hg-codes/Audio-Amplifier/plots/circuit/BandPassFilter.png

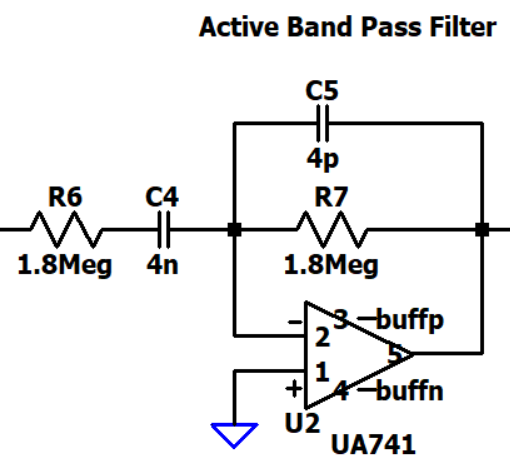
plots/circuit/BandPassFilter.png
