hg-codes/Audio-Amplifier/plots/circuit/FullCkt.png

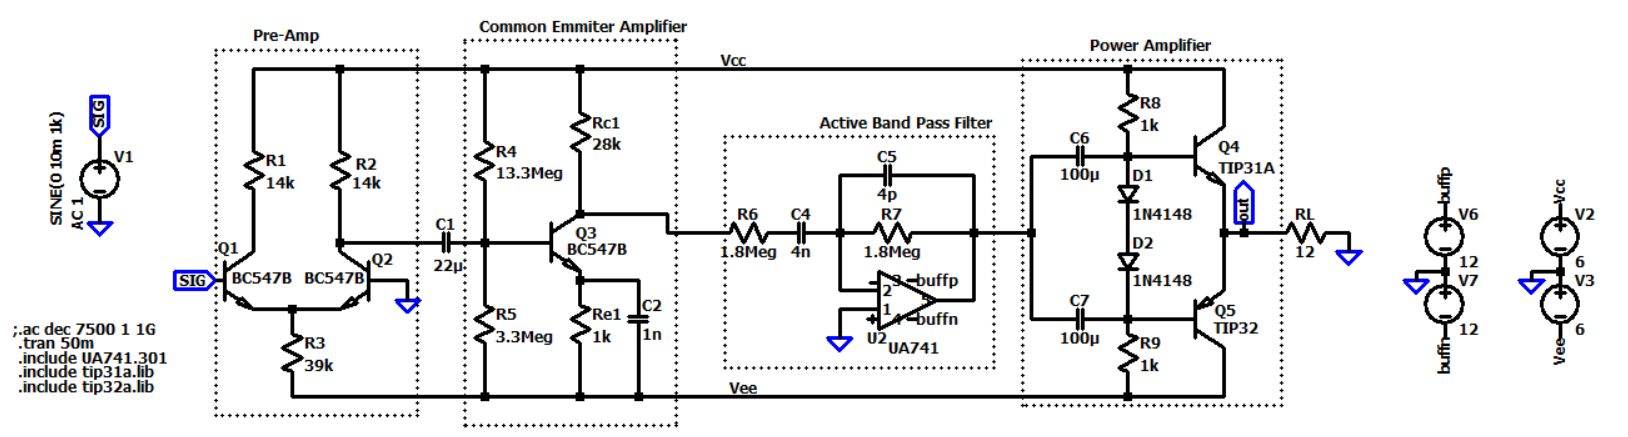
plots/circuit/FullCkt.png
