hg-codes/Audio-Amplifier/plots/circuit/InputSignal.png

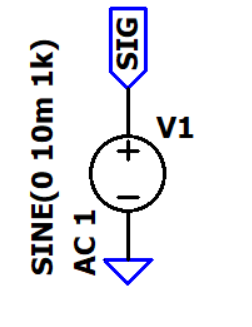
plots/circuit/InputSignal.png
