hg-codes/Audio-Amplifier/plots/circuit/InputSupply.png

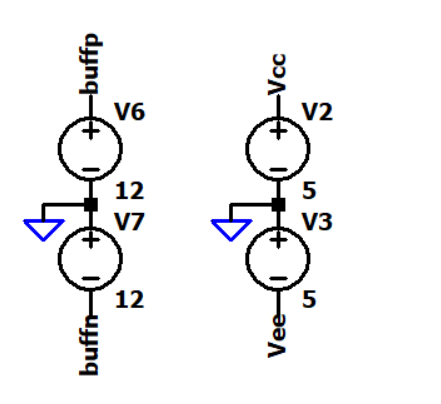
plots/circuit/InputSupply.png
