hg-codes/Audio-Amplifier/plots/spiceplots/BandPassBode.png

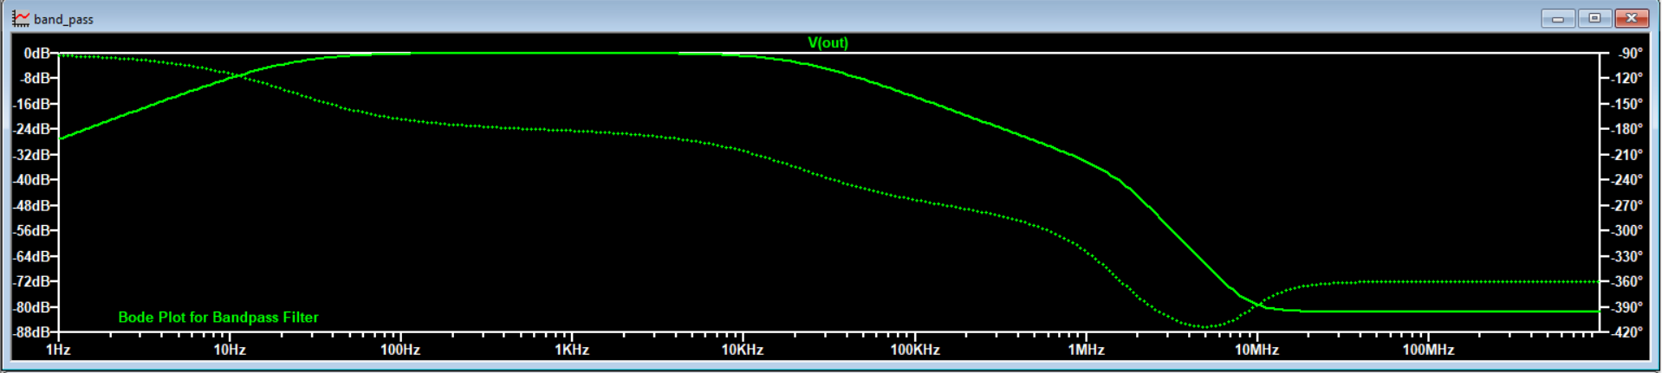
plots/spiceplots/BandPassBode.png
