hg-codes/Audio-Amplifier/plots/spiceplots/Compare.png

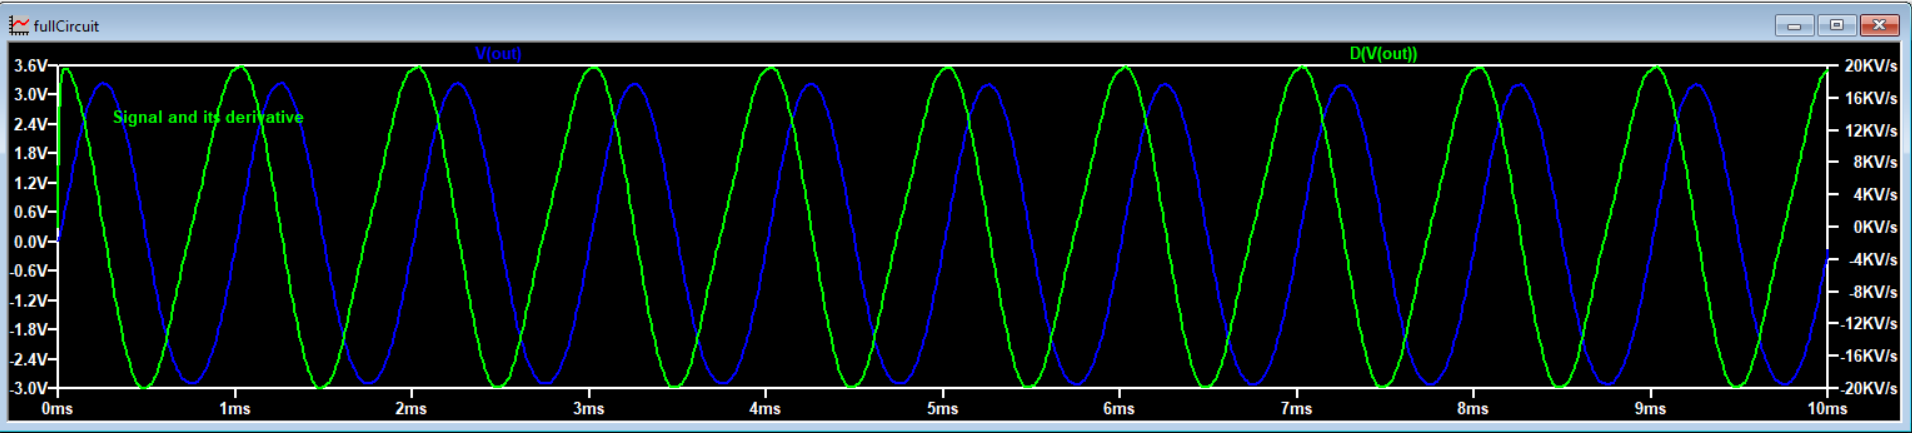
plots/spiceplots/Compare.png
