hg-codes/Audio-Amplifier/plots/spiceplots/FFT4.png

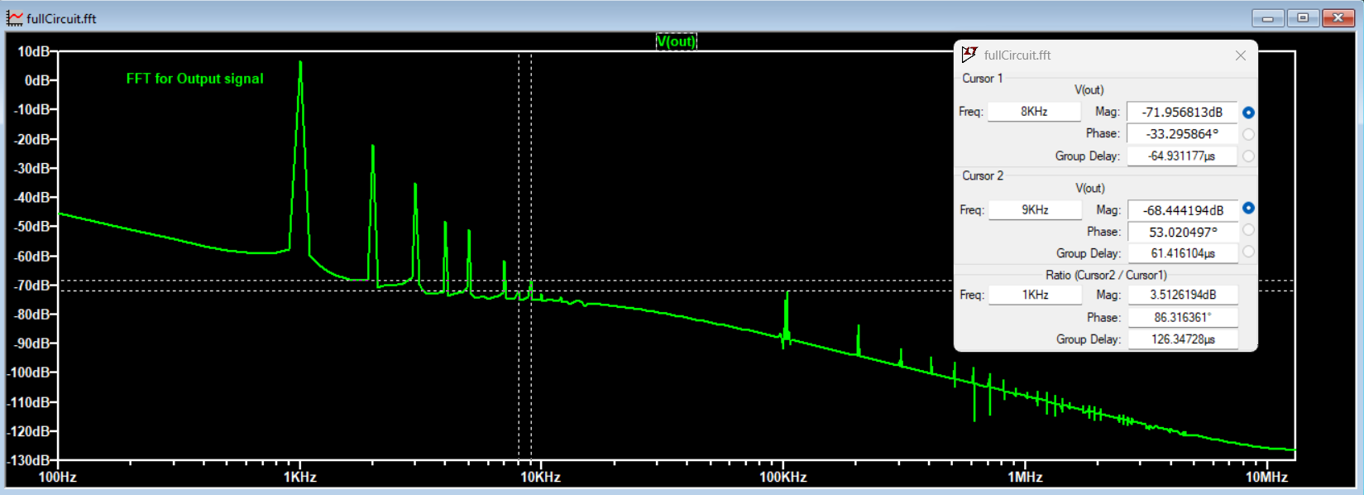
plots/spiceplots/FFT4.png
