hg-codes/Audio-Amplifier/plots/spiceplots/InputPower.png

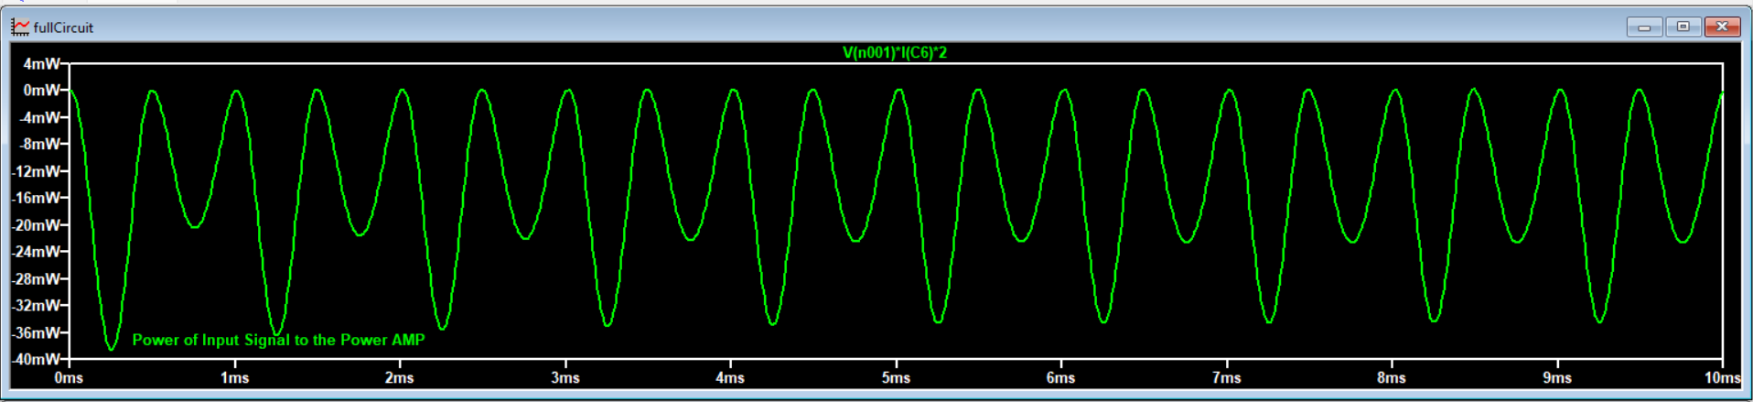
plots/spiceplots/InputPower.png
