hg-codes/Audio-Amplifier/plots/spiceplots/InputSignal.png

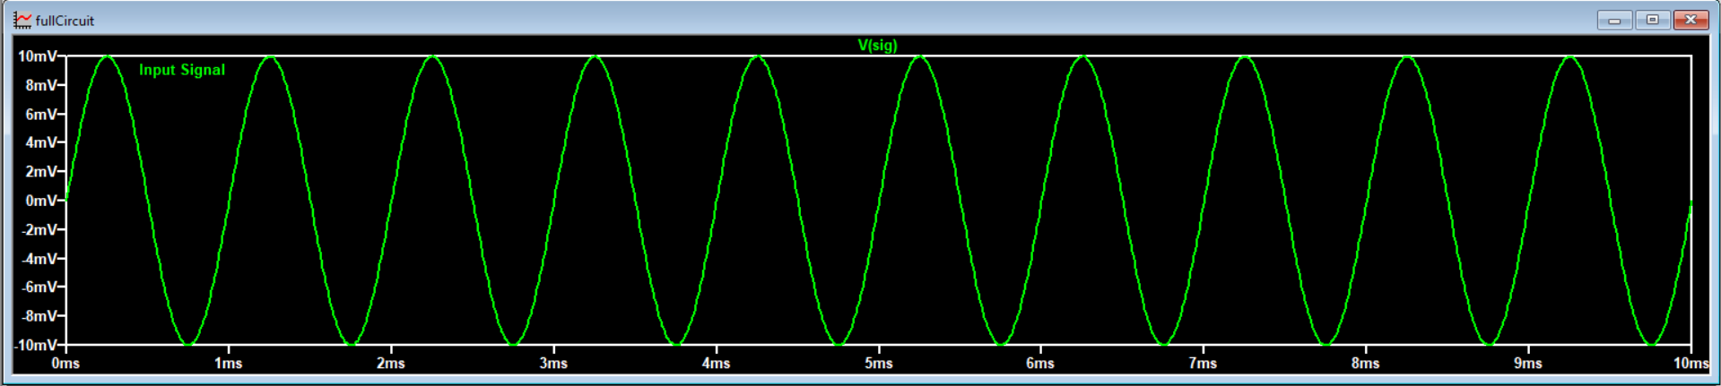
plots/spiceplots/InputSignal.png
