hg-codes/Audio-Amplifier/plots/spiceplots/OutputBode.png

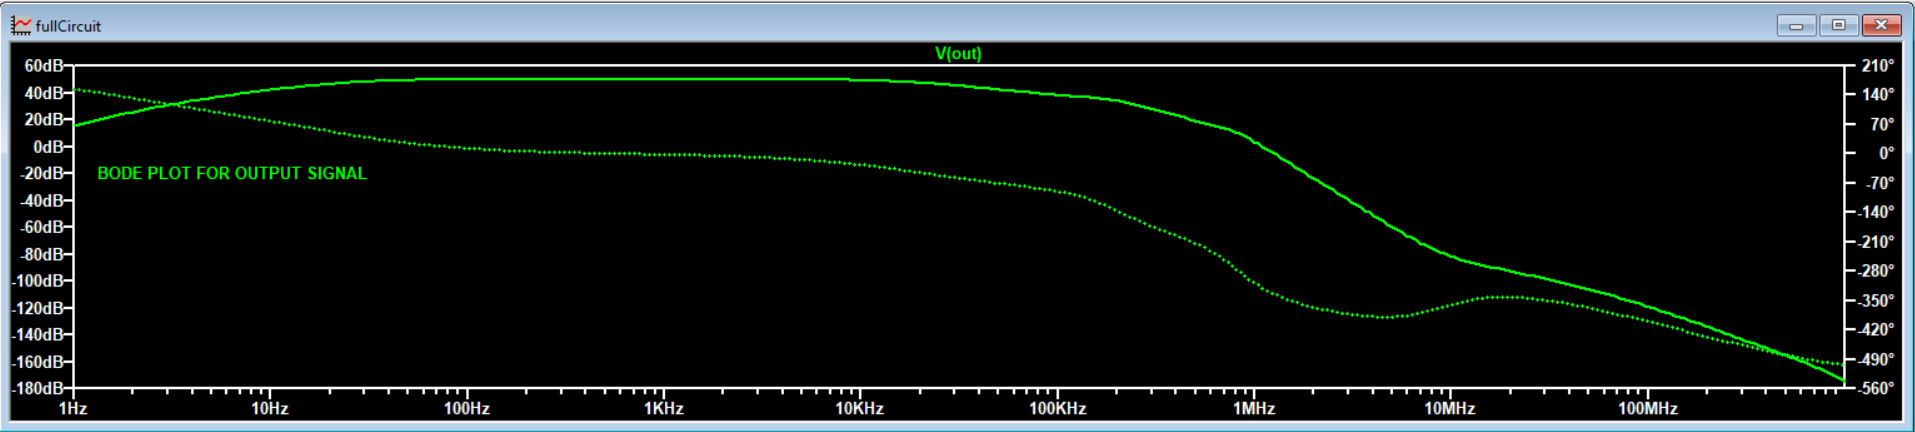
plots/spiceplots/OutputBode.png
