hg-codes/Audio-Amplifier/plots/spiceplots/OutputBodeReadings.png

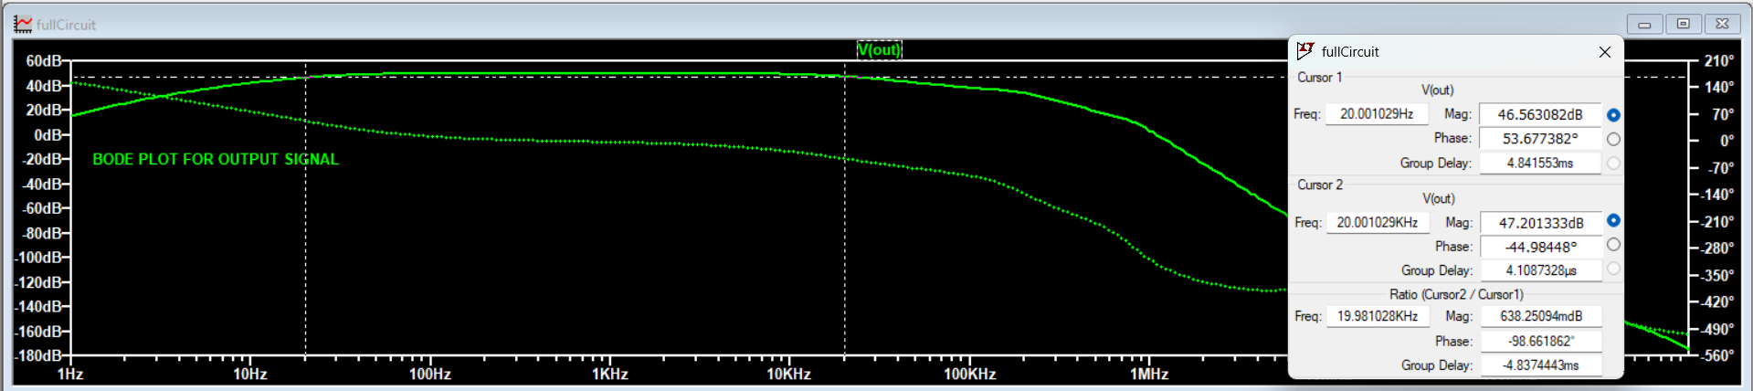
plots/spiceplots/OutputBodeReadings.png
