hg-codes/Audio-Amplifier/plots/spiceplots/OutputPower.png

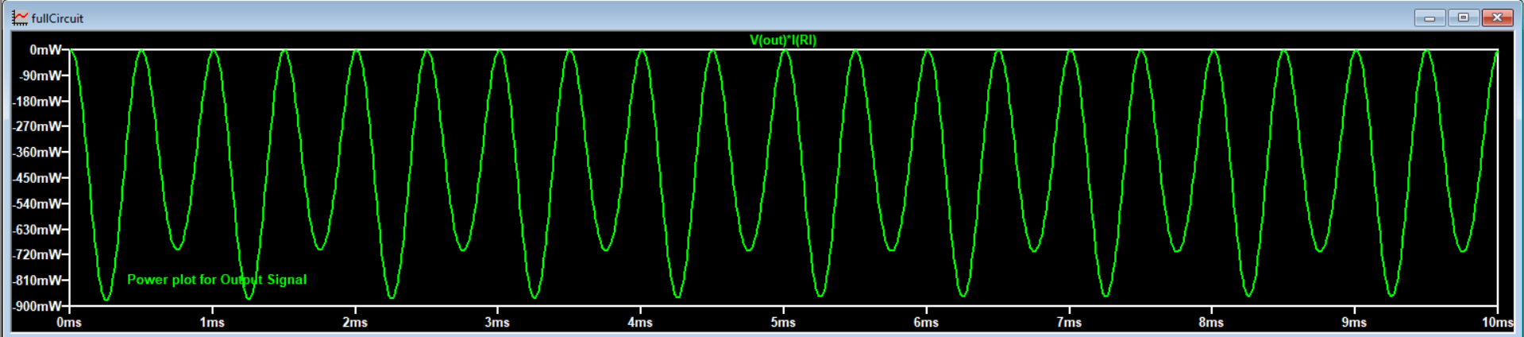
plots/spiceplots/OutputPower.png
