hg-codes/Audio-Amplifier/plots/spiceplots/PowerAmp.png

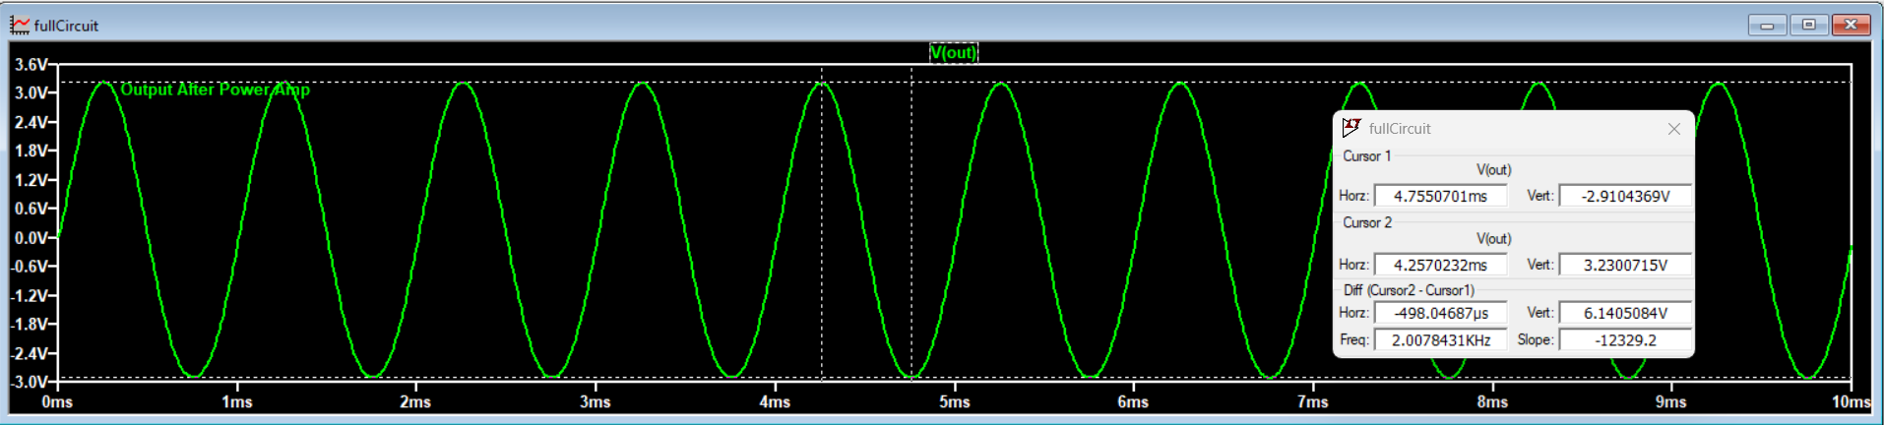
plots/spiceplots/PowerAmp.png
