hg-codes/Audio-Amplifier/plots/experiment/15kOutput20mv.png

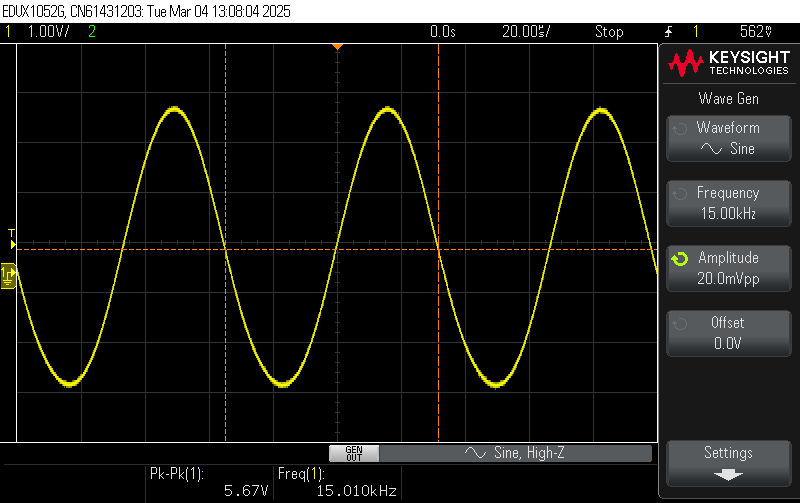
plots/experiment/15kOutput20mv.png
