hg-codes/Audio-Amplifier/plots/experiment/BodeReading1.png

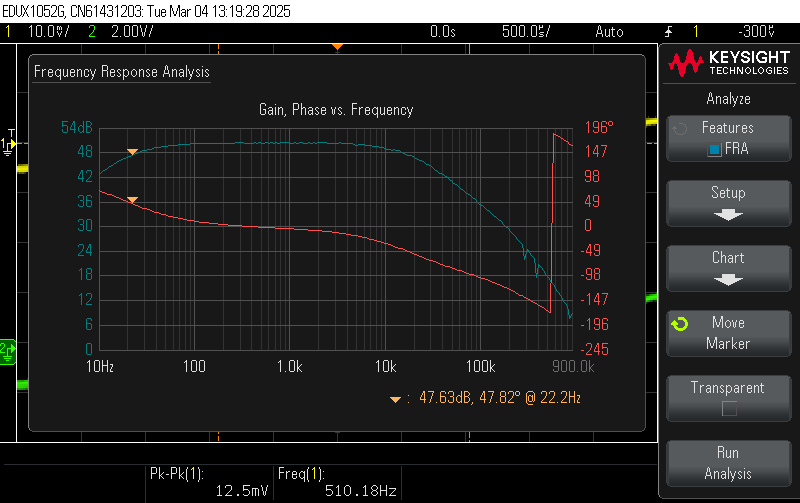
plots/experiment/BodeReading1.png
