hg-codes/Audio-Amplifier/plots/experiment/Compare.png

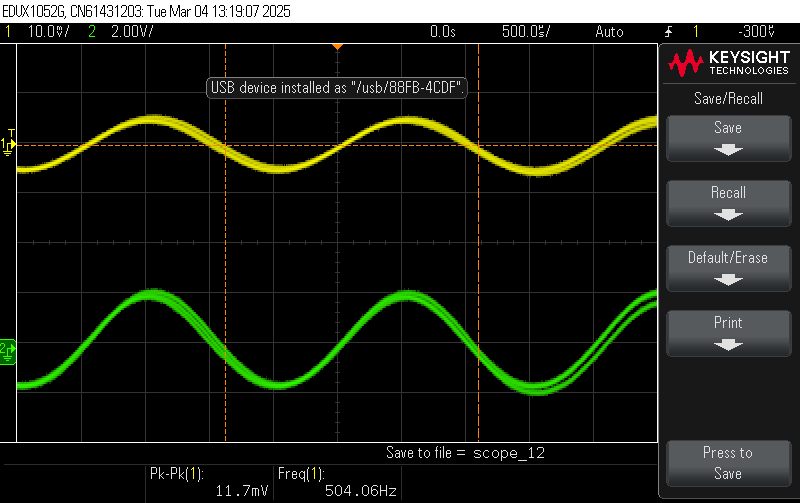
plots/experiment/Compare.png
