hg-codes/Audio-Amplifier/plots/experiment/FFT.png

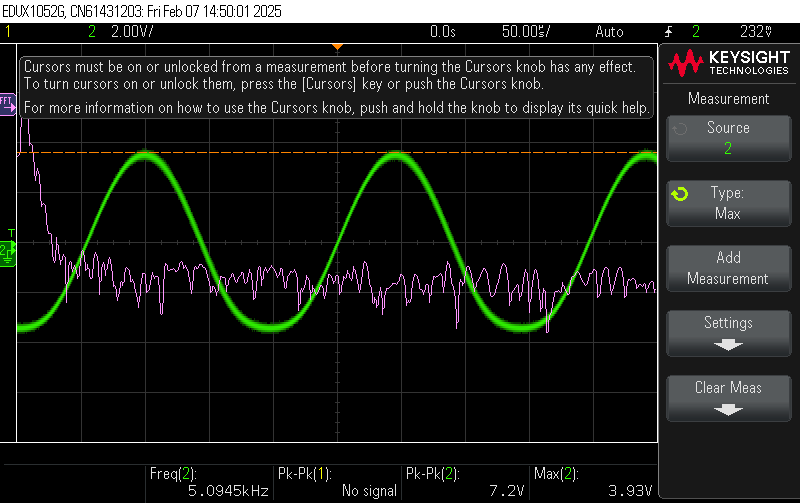
plots/experiment/FFT.png
