hg-codes/Audio-Amplifier/plots/experiment/scope_4.png

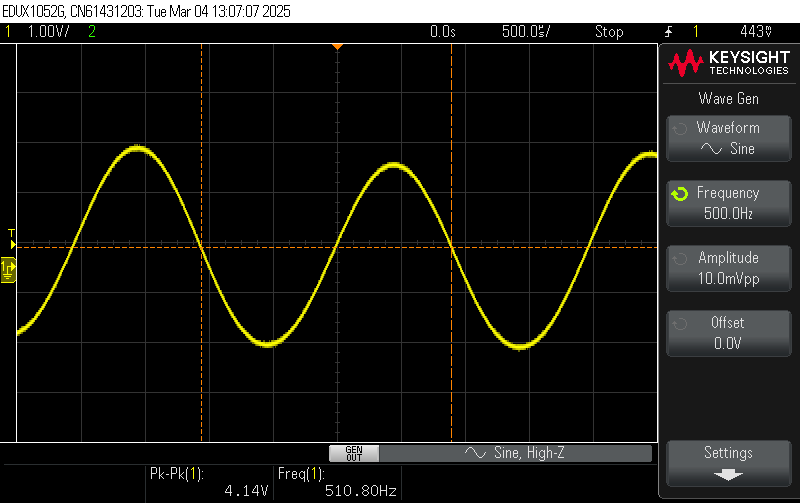
plots/experiment/scope_4.png
