hg-codes/Audio-Amplifier/plots/experiment/scope_9.png

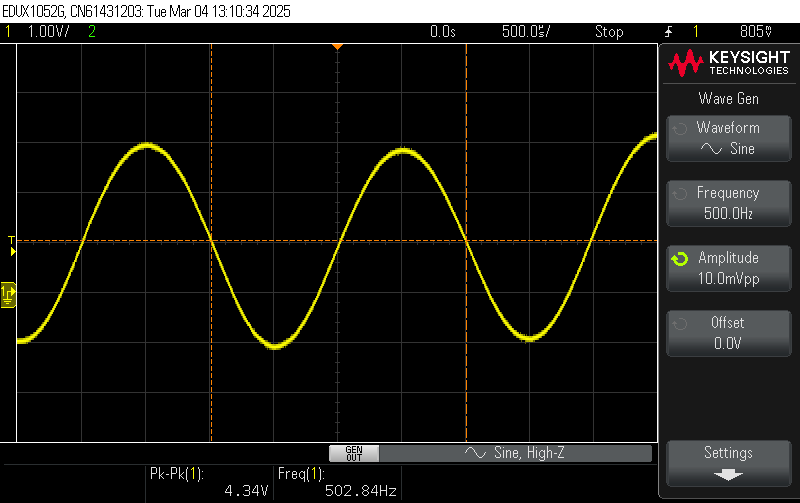
plots/experiment/scope_9.png
