hg-codes/Audio-Amplifier/plots/experiment/scope_11.png

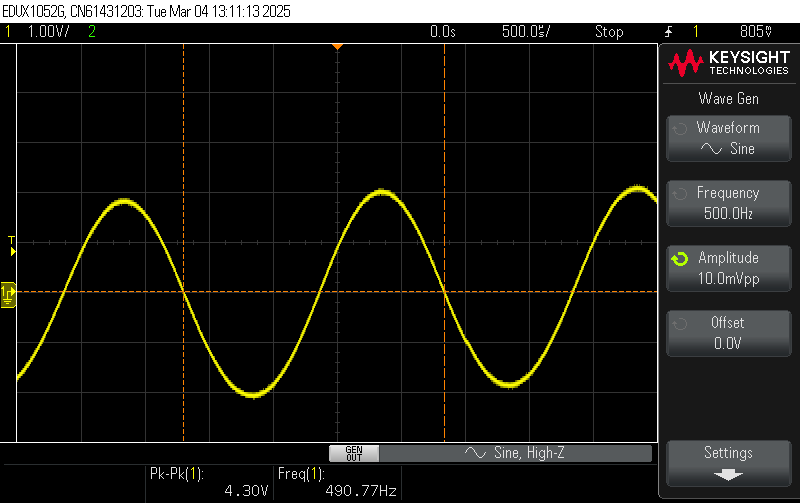
plots/experiment/scope_11.png
