hg-codes/Audio-Amplifier/plots/results/AvgInPower.png

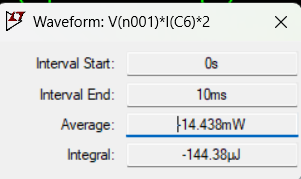
plots/results/AvgInPower.png
