hg-codes/Audio-Amplifier/plots/results/AvgOutPower.png

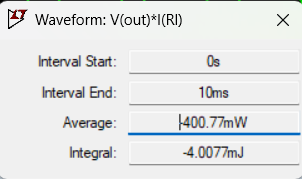
plots/results/AvgOutPower.png
