hg-codes/Audio-Amplifier/plots/results/MaxGain.png

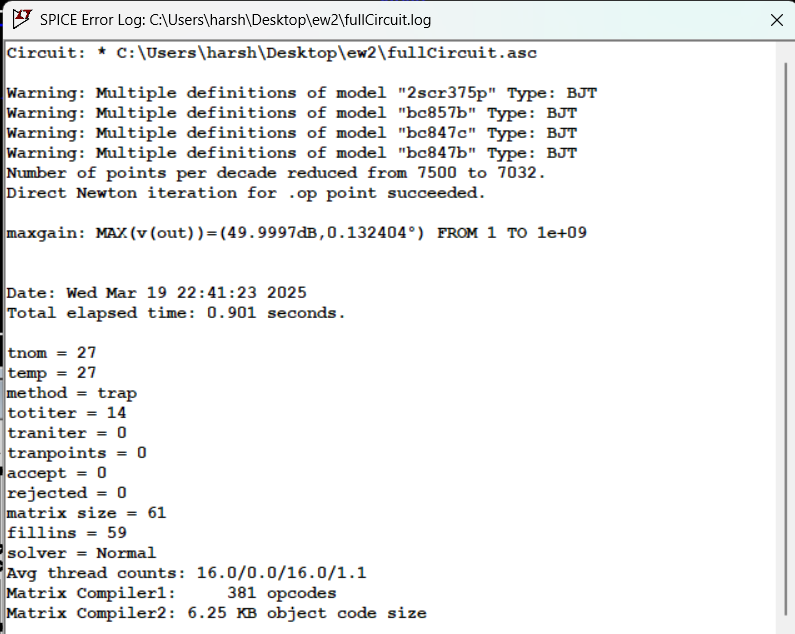
plots/results/MaxGain.png
