hg-codes/Audio-Amplifier/code/fullCircuit.asc

C1: cap; 22µ
C2: cap; 1n
C4: cap; 4n
C5: cap; 4p
C6: cap; 100µ
C7: cap; 100µ
D1: diode; 1N4148
D2: diode; 1N4148
Q1: npn; BC547B
Q2: npn; BC547B
Q3: npn; BC547B
Q4: npn; TIP31A
Q5: pnp; TIP32
R1: res; 14k
R2: res; 14k
R3: res; 39k
R4: res; 13.3Meg
R5: res; 3.3Meg
R6: res; 1.8Meg
R7: res; 1.8Meg
R8: res; 1k
R9: res; 1k
Rc1: res; 28k
Re1: res; 1k
RL: res; 12
U2: UA741
V1: voltage; SINE(0 10m 1k); AC 1
V2: voltage; 5
V3: voltage; 5
V6: voltage; 12
V7: voltage; 12
Named nets: SIG, 0, Vcc, Vee, buffp, buffn, out
;.ac dec 7500 1 1G
.tran 10m
.include UA741.301
.include tip31a.lib
.include tip32a.lib
Pre-Amp
Common Emmiter Amplifier
Active Band Pass Filter
Power Amplifier
.meas TRAN max d(Vout)/dt MAX D(V(out)) FROM 0ms TO 10m
